madhukartemba/eternal_nrf/README.md

# eternal_nrf
A solar powered nRF based BLE contact sensor.
