madhukartemba/eternal_nrf/3d_print/Spacer.stl

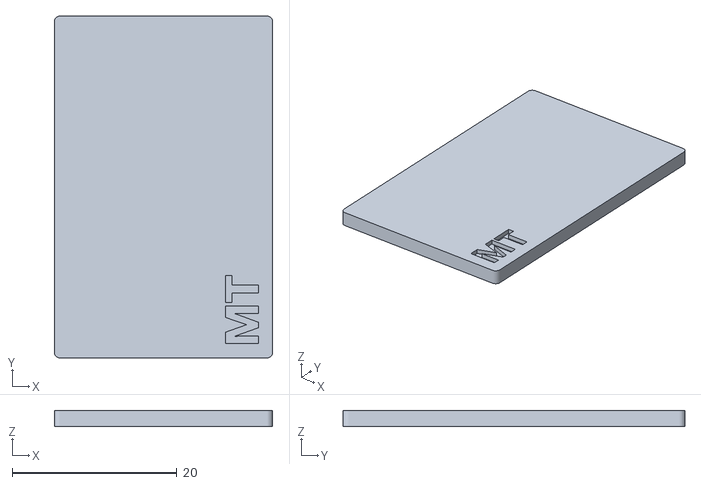
[picture p1: CAD file, 2026-11-03]
3d_print/Spacer.stl
26.5 x 41.5 x 2.00
