madhukartemba/eternal_nrf/3d_print/Magnet.stl

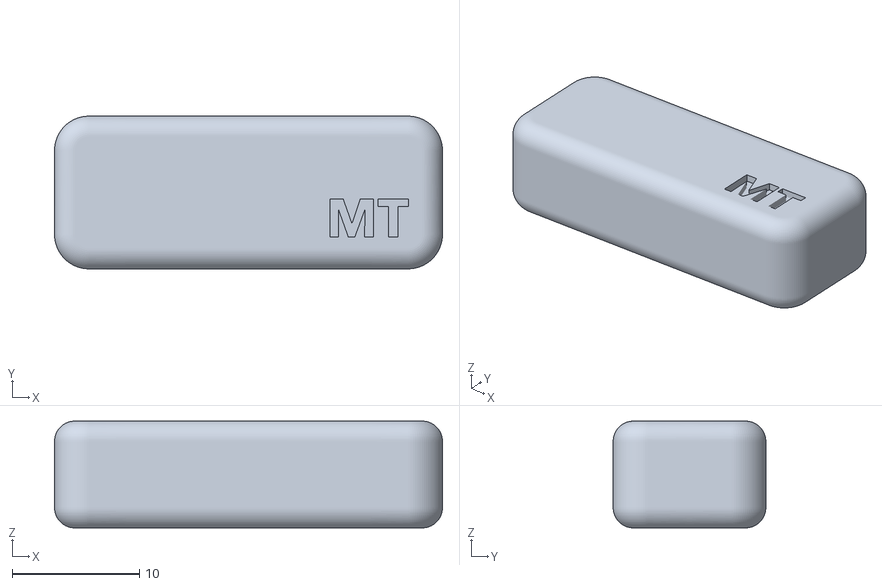
[picture p2: CAD file, 2026-11-02]
3d_print/Magnet.stl
30.5 x 12.0 x 8.40
