madhukartemba/eternal_nrf/3d_print/Top.stl

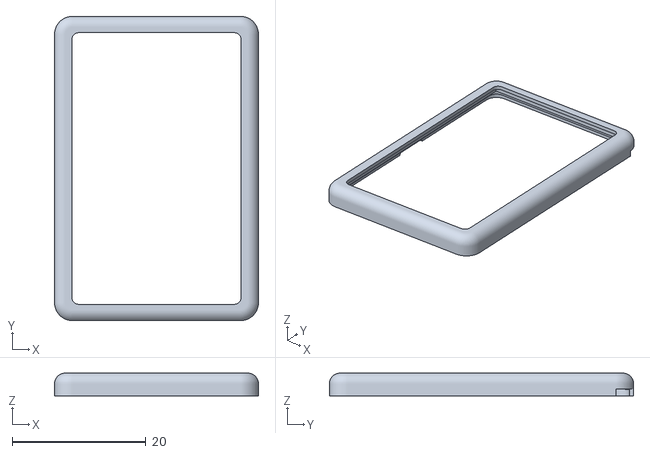
[picture p3: CAD file, 2026-11-02]
3d_print/Top.stl
30.5 x 45.5 x 3.40
