madhukartemba/eternal_nrf/3d_print/Bottom.stl

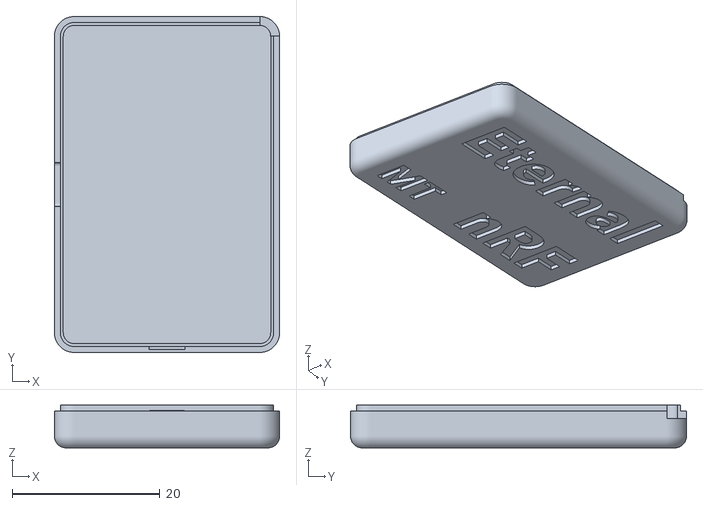
[picture p4: CAD file, 2026-11-02]
3d_print/Bottom.stl
30.5 x 45.5 x 5.80
