madhukartemba/eternal_nrf/3d_print/Button.stl

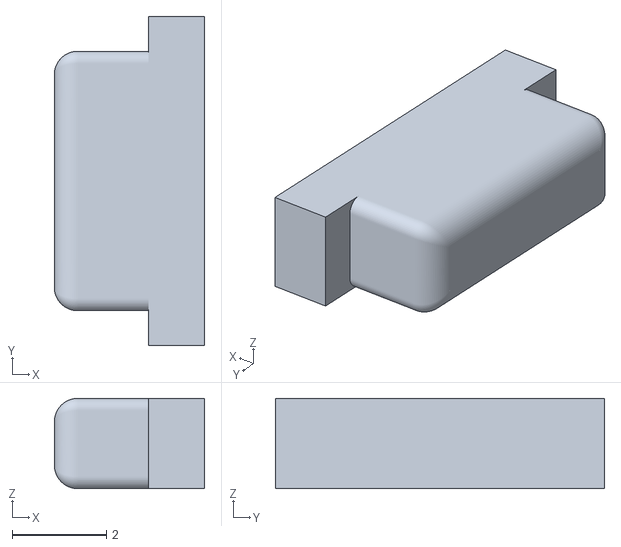
[picture p5: CAD file, 2026-11-02]
3d_print/Button.stl
3.20 x 7.00 x 1.92
