madhukartemba/eternal_nrf/(list of files, cad)

Other CAD files:
3d_print/Eternal nRF.f3d
