madhukartemba/eternal_nrf/eternal_nrf_pcb/eternal_nrf_pcb.kicad_pcb

## KiCad design eternal_nrf_pcb/eternal_nrf_pcb.kicad_pcb (2026-05-19)

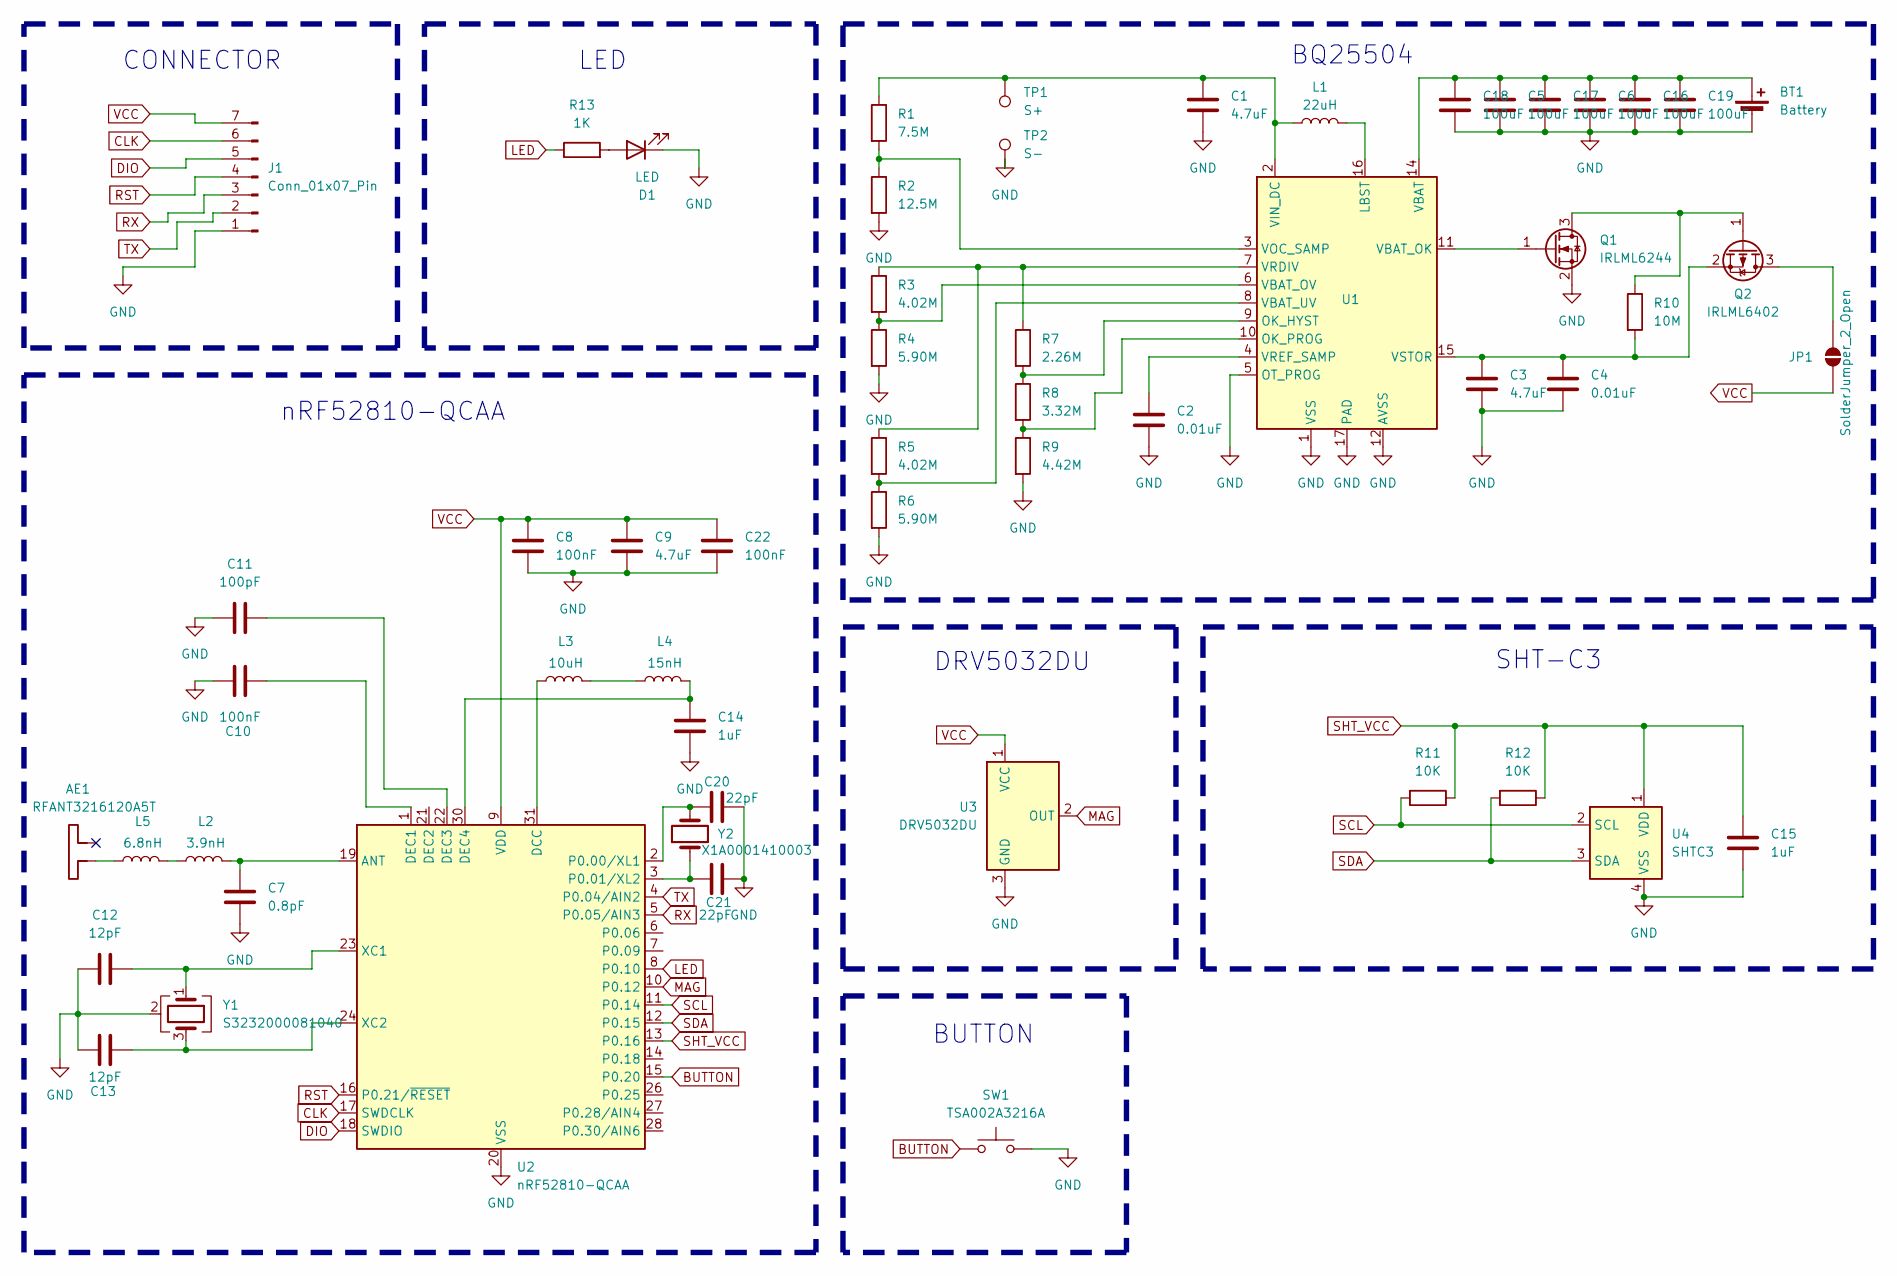
[picture p6: schematic eternal_nrf_pcb.kicad_sch, Eternal nRF]

Parts:
AE1: RFANT3216120A5T; Johanson_2450AT18x100
BT1: Battery; BatteryHolder_Seiko_MS621F
C1, C3: 4.7uF; C_0805_2012Metric
C2, C4: 0.01uF; C_0603_1608Metric
C5, C6, C16, C17, C18, C19: 100uF; C_1210_3225Metric
C7: 0.8pF; C_0402_1005Metric_Pad0.74x0.62mm_HandSolder
C8, C10, C22: 100nF; C_0402_1005Metric_Pad0.74x0.62mm_HandSolder
C9: 4.7uF; C_0603_1608Metric_Pad1.08x0.95mm_HandSolder
C11: 100pF; C_0402_1005Metric_Pad0.74x0.62mm_HandSolder
C12, C13: 12pF; C_0402_1005Metric_Pad0.74x0.62mm_HandSolder
C14, C15: 1uF; C_0402_1005Metric_Pad0.74x0.62mm_HandSolder
C20, C21: 22pF; C_0402_1005Metric_Pad0.74x0.62mm_HandSolder
D1: LED; LED_0603_1608Metric
J1: Conn_01x07_Pin; PinHeader_1x07_P2.54mm_Vertical
JP1: SolderJumper_2_Open; SolderJumper-2_P1.3mm_Open_TrianglePad1.0x1.5mm
L1: 22uH; L_Sunlord_SWPA4030S
L2: 3.9nH; L_0402_1005Metric_Pad0.77x0.64mm_HandSolder
L3: 10uH; L_0603_1608Metric_Pad1.05x0.95mm_HandSolder
L4: 15nH; L_0402_1005Metric_Pad0.77x0.64mm_HandSolder
L5: 6.8nH; L_0402_1005Metric_Pad0.77x0.64mm_HandSolder
Q1: IRLML6244; SOT-23
Q2: IRLML6402; SOT-23
R1: 7.5M; R_0603_1608Metric_Pad0.98x0.95mm_HandSolder
R2: 12.5M; R_0603_1608Metric_Pad0.98x0.95mm_HandSolder
R3, R5: 4.02M; R_0603_1608Metric_Pad0.98x0.95mm_HandSolder
R4, R6: 5.90M; R_0603_1608Metric_Pad0.98x0.95mm_HandSolder
R7: 2.26M; R_0603_1608Metric_Pad0.98x0.95mm_HandSolder
R8: 3.32M; R_0603_1608Metric_Pad0.98x0.95mm_HandSolder
R9: 4.42M; R_0603_1608Metric_Pad0.98x0.95mm_HandSolder
R10: 10M; R_0603_1608Metric_Pad0.98x0.95mm_HandSolder
R11, R12: 10K; R_0402_1005Metric_Pad0.72x0.64mm_HandSolder
R13: 1K; R_0402_1005Metric_Pad0.72x0.64mm_HandSolder
SW1: TSA002A3216A; TST-A002_0.6MM_BOSS
TP1: S+; TestPoint_Pad_D2.0mm
TP2: S-; TestPoint_Pad_D2.0mm
U1: BQ25504; VQFN-16-1EP_3x3mm_P0.5mm_EP1.68x1.68mm
U2: nRF52810-QCAA; QFN-32-1EP_5x5mm_P0.5mm_EP3.6x3.6mm
U3: DRV5032DU; SOT-23
U4: SHTC3; Sensirion_DFN-4-1EP_2x2mm_P1mm_EP0.7x1.6mm
Y1: S3232000081040; Crystal_SMD_3225-4Pin_3.2x2.5mm
Y2: X1A0001410003; Crystal_SMD_3215-2Pin_3.2x1.5mm

Connections:
BUTTON: SW1.1, U2.15 (P0.20)
CLK: J1.6, U2.17 (SWDCLK)
DIO: J1.5, U2.18 (SWDIO)
GND: BT1.2 (-), C1.2, C2.2, C3.2, C4.2, C5.2, C6.2, C7.2, C8.2, C9.2, C10.1, C11.1, C12.1, C13.1, C14.2, C15.2, C16.2, C17.2, C18.2, C19.2, C20.1, C21.2, C22.2, D1.1 (K), J1.1, Q1.2 (S), R2.2, R4.2, R6.2, R9.2, SW1.2, TP2.1 (1_1), U1.1 (VSS), U1.5 (OT_PROG), U1.12 (AVSS), U1.13 (VSS), U1.17 (PAD), U2.20 (VSS), U2.29 (VSS), U2.33 (VSS), U3.3 (GND), U4.4 (VSS), Y1.2 (G), Y1.4 (G)
LED: R13.1, U2.8 (P0.10)
MAG: U2.10 (P0.12), U3.2 (OUT)
unnamed: AE1.1, L5.1
unnamed: BT1.1 (+), C5.1, C6.1, C16.1, C17.1, C18.1, C19.1, U1.14 (VBAT)
unnamed: D1.2 (A), R13.2
unnamed: JP1.2 (B), Q2.3 (D)
unnamed: L2.1, L5.2
unnamed: L3.2, L4.1
unnamed: Q1.3 (D), Q2.1 (G), R10.1
unnamed: Q1.1 (G), U1.11 (VBAT_OK)
unnamed: C3.1, C4.1, Q2.2 (S), R10.2, U1.15 (VSTOR)
unnamed: L1.2, U1.16 (LBST)
unnamed: R7.2, R8.1, U1.9 (OK_HYST)
unnamed: R8.2, R9.1, U1.10 (OK_PROG)
unnamed: R3.2, R4.1, U1.6 (VBAT_OV)
unnamed: R5.2, R6.1, U1.8 (VBAT_UV)
unnamed: C1.1, L1.1, R1.1, TP1.1 (1_1), U1.2 (VIN_DC)
unnamed: R1.2, R2.1, U1.3 (VOC_SAMP)
unnamed: R3.1, R5.1, R7.1, U1.7 (VRDIV)
unnamed: C2.1, U1.4 (VREF_SAMP)
unnamed: C7.1, L2.2, U2.19 (ANT)
unnamed: L3.1, U2.31 (DCC)
unnamed: C10.2, U2.1 (DEC1)
unnamed: C11.2, U2.22 (DEC3)
unnamed: C14.1, L4.2, U2.30 (DEC4)
unnamed: C21.1, U2.2 (P0.00/XL1), Y2.2
unnamed: C20.2, U2.3 (P0.01/XL2), Y2.1
unnamed: C12.2, U2.23 (XC1), Y1.1
unnamed: C13.2, U2.24 (XC2), Y1.3
RST: J1.4, U2.16 (P0.21/~RESET)
RX: J1.3, U2.5 (P0.05/AIN3)
SCL: R11.2, U2.11 (P0.14), U4.2 (SCL)
SDA: R12.2, U2.12 (P0.15), U4.3 (SDA)
SHT_VCC: C15.1, R11.1, R12.1, U2.13 (P0.16), U4.1 (VDD)
TX: J1.2, U2.4 (P0.04/AIN2)
VCC: C8.1, C9.1, C22.1, J1.7, JP1.1 (A), U2.9 (VDD), U2.25 (VDD), U2.32 (VDD), U3.1 (VCC)

Notes on the sheet:
BQ25504
BUTTON
nRF52810-QCAA
DRV5032DU
CONNECTOR
SHT-C3
LED

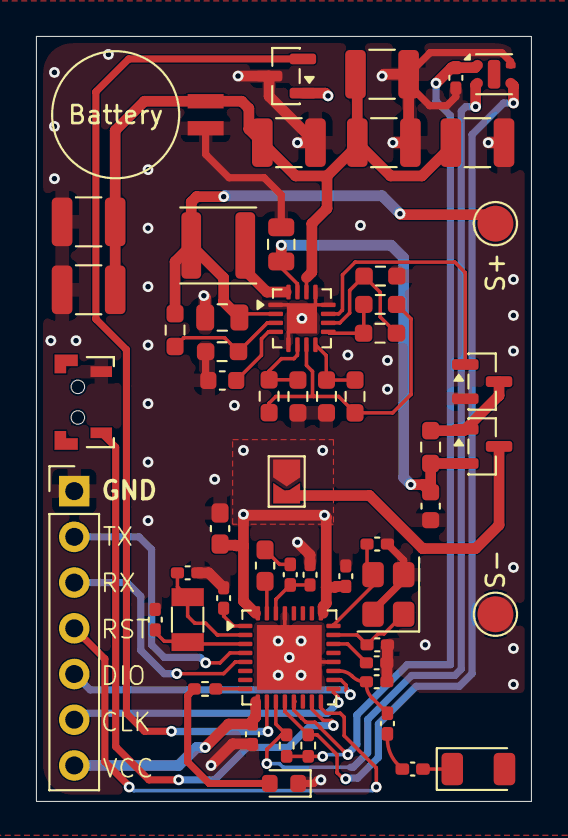
[picture p7: board eternal_nrf_pcb.kicad_pcb from above]

Board: 4 copper layers, 27.5 x 42.5 mm, 56 parts (0 on the bottom side), 40 nets.
