madhukartemba/eternal_nrf/(commit log)

2026-05-04 add resistor values
    [eternal_nrf_pcb.kicad_pcb, eternal_nrf_pcb.kicad_sch]
2026-05-05 add nrf barebones schema
    [eternal_nrf_pcb.kicad_pcb, eternal_nrf_pcb.kicad_sch]
2026-05-05 add footprints
    [eternal_nrf_pcb.kicad_pcb, eternal_nrf_pcb.kicad_sch]
2026-05-05 add button and led
    [eternal_nrf_pcb.kicad_sch]
2026-05-05 add footprint
    [eternal_nrf_pcb.kicad_sch]
2026-05-06 place parts
    [eternal_nrf_pcb.kicad_pcb, eternal_nrf_pcb.kicad_sch]
2026-05-08 almost final layout
    [eternal_nrf_pcb.kicad_pcb, eternal_nrf_pcb.kicad_sch]
2026-05-08 somewhat complete wiring
    [eternal_nrf_pcb.kicad_pcb]
2026-05-08 almost complete design, touch ups are pending
    [eternal_nrf_pcb.kicad_pcb]
2026-05-08 change fonts
    [eternal_nrf_pcb.kicad_pcb]
2026-05-08 final pcb (rev 1 :))
    [eternal_nrf_pcb.kicad_pcb]
2026-05-08 update sheet info
    [eternal_nrf_pcb.kicad_pcb, eternal_nrf_pcb.kicad_sch]
2026-05-10 complete board
    [eternal_nrf_pcb.kicad_pcb, eternal_nrf_pcb.kicad_sch]
2026-05-10 increase trace width
    [eternal_nrf_pcb.kicad_pcb, eternal_nrf_pcb.kicad_sch]
2026-05-10 add production file
    [eternal_nrf_pcb.kicad_pcb, eternal_nrf_pcb.kicad_sch]
2026-05-10 fix bugs
    [eternal_nrf_pcb.kicad_pcb, eternal_nrf_pcb.kicad_sch]
2026-05-10 final production file
    [eternal_nrf_pcb.kicad_pcb, eternal_nrf_pcb.kicad_sch]
2026-05-19 add missing route :(
    [eternal_nrf_pcb.kicad_pcb]
2026-06-01 add battery less version
2026-06-01 update battery less code
2026-06-01 flash led breifly
2026-11-01 advertise before sensor init and spend less energy between bursts
2026-11-01 init SHTC3 before BLE so a 100 uF boot still sends a real sample
2026-11-02 add enclosure STLs, Fusion model, and Creality print files
2026-11-02 add Creality Set_7 gcode for the enclosure print
2026-11-02 add magnet print files and update the Fusion enclosure model
2026-11-03 add spacer print files and update the Fusion enclosure model
